fstocco-spec/esp-iot-monitor/ESP32 Gate Controller Spec v2.docx

ESP32 GATE CONTROLLER

Especificacao Tecnica de Produto

Versao 2.0

Fabio Stocco | Smatec Sistemas Embarcados

Campinas, SP | 2025

Status do Projeto | Em desenvolvimento ativo — Firmware Stages 1-6 concluidos
Hardware atual | ESP32 + 4 reles + 4 reeds + display TFT + botoes
Hardware definido (v2) | + TRIAC + ACS712 + CC1101 RF + 2 reles aux
Proxima etapa FW | Stage 7 — Reles auxiliares (trava + luz)

# 1. Visao Geral do Produto

O ESP32 Gate Controller e uma central de comando para portoes automaticos de duas folhas (pivotante, basculante ou deslizante), desenvolvida sobre plataforma ESP32 com FreeRTOS. O produto e posicionado na camada profissional-instalador: configuracao completa por display local, interface web sem dependencia de nuvem, e arquitetura de firmware modular preparada para expansao.

O diferencial central em relacao ao mercado e a combinacao de display TFT com menu completo, interface web local, e base de firmware extensivel — caracteristicas que no mercado convencional existem apenas em produtos de linha industrial ou como acessorios pagos separados.

## 1.1 Posicionamento de Mercado

Aspecto | Mercado residencial | ESP32 Gate Controller
Configuracao | LEDs piscantes + jumpers + trimpots | Display TFT com menu navegavel
Interface web | App proprietario + nuvem do fabricante | Web local, sem app, sem nuvem
Programador externo | PROG opcional R$80-120 (PPA) | Integrado — display permanente
Log de eventos | Nao disponivel | 50-100 entradas em NVS com timestamp NTP
Controle remoto | RF 433MHz OOK codigo fixo | CC1101 — OOK compativel + sensibilidade superior
Integracao smart home | App proprietario fechado | HomeKit + MQTT (roadmap)
Dependencia de fornecedor | Alta — servidor encerrado = sem app | Zero — opera standalone

## 1.2 Tipos de Portao Suportados

- Portao de duas folhas pivotante — uso principal, controle independente por folha com delay configuravel
- Portao basculante de uma folha — controle completo, reed switches de fim de curso
- Portao deslizante de uma folha — mesma logica, reed de abertura e fechamento

INFO: Para duas folhas, o controle de potencia (TRIAC) e compartilhado — ambas recebem a mesma tensao. Controle independente de velocidade por folha requer dois TRIACs (roadmap futuro).

# 2. Especificacao de Hardware

## 2.1 Bill of Materials (BOM Completo v2)

Componente | Modelo / Especificacao | Qtd | Status
MCU | ESP32-WROOM-32 DevKit 38 pinos | 1 | Atual
Display TFT | ST7735 1.8" 160x128 SPI | 1 | Atual
Modulo de reles (direcao) | 4 canais, optoacoplador, 5V, ativo HIGH | 1 | Atual
Reed switch magnetico | NO, 2 por folha (abertura + fechamento) | 4 | Atual
Botao tact | GATE, +, -, OK (4 total) | 4 | Atual
Fonte chaveada isolada | Hi-Link HLK-5M05 — 220VAC -> 5VDC | 1 | Atual
Varistor MOV | Protecao contra surto na entrada AC | 1 | Atual
Resistor pull-up | 10kOhm — GPIOs 34/35 sem pull-up interno | 2 | Atual
TRIAC | BTA24-600 — 600V 25A | 1 | HW v2
Optoacoplador gate TRIAC | MOC3021 — sem zero-crossing | 1 | HW v2
Optoacoplador zero-crossing | 4N25 + resistores divisor | 1 | HW v2
Snubber TRIAC | 100 Ohm + 10nF/400V em serie | 1 | HW v2
Sensor de corrente | ACS712-20A — efeito Hall, 100mV/A | 1 | HW v2
Modulo RF 433MHz | CC1101 com antena SMA externa | 1 | HW v2
Reles auxiliares | 5V optoacoplador — trava e luz/sinaleiro | 2 | HW v2
Fusivel AC | 2A retardado — entrada 220VAC | 1 | HW v2

## 2.2 Mapa de GPIOs

GPIO | Sinal | Direcao | Descricao | HW
25 | RELAY_L1_OPEN | OUT | Rele abertura folha 1 | Atual
26 | RELAY_L1_CLOSE | OUT | Rele fechamento folha 1 | Atual
27 | RELAY_L2_OPEN | OUT | Rele abertura folha 2 | Atual
14 | RELAY_L2_CLOSE | OUT | Rele fechamento folha 2 | Atual
13 | RELAY_AUX1 | OUT | Rele auxiliar 1 — padrao: trava | v2
12 | RELAY_AUX2 | OUT | Rele auxiliar 2 — padrao: luz/sinaleiro | v2
34 | REED_OPEN_L1 | IN | Reed abertura folha 1 — input-only, pull-up externo | Atual
35 | REED_CLOSE_L1 | IN | Reed fechamento folha 1 — input-only, pull-up externo | Atual
32 | REED_OPEN_L2 | IN | Reed abertura folha 2 — INPUT_PULLUP | Atual
33 | REED_CLOSE_L2 | IN | Reed fechamento folha 2 — INPUT_PULLUP | Atual
21 | TRIAC_GATE | OUT | PWM phase-cut via MOC3021 — LEDC timer | v2
36 | ZERO_CROSS | IN | Deteccao de zero-crossing AC — input-only | v2
39 | ACS712_OUT | ADC | Saida analoga sensor corrente — ADC1_CH3 | v2
22 | BTN_GATE | IN | Botao acionamento portao — INPUT_PULLUP | Atual
16 | BTN_MINUS | IN | Botao menu menos — INPUT_PULLUP | Atual
17 | BTN_PLUS | IN | Botao menu mais — INPUT_PULLUP | Atual
0 | BTN_OK | IN | Botao OK — INPUT_PULLUP — boot pin | Atual
5 | TFT_CS | OUT | Display chip select — SPI | Atual
2 | TFT_DC | OUT | Display data/command | Atual
4 | TFT_RST | OUT | Display reset | Atual
23 | SPI_MOSI | OUT | SPI MOSI — TFT + CC1101 compartilhado | Atual
18 | SPI_SCK | OUT | SPI SCK — TFT + CC1101 compartilhado | Atual
19 | SPI_MISO | IN | SPI MISO — CC1101 (TFT nao usa MISO) | v2
15 | CC1101_CSN | OUT | CC1101 chip select — SPI | v2
3 | CC1101_GDO0 | IN | CC1101 saida dados OOK demodulados — RX0 em producao | v2

NOTA: GPIOs 34, 35, 36, 39 sao input-only: sem pull-up interno e sem capacidade de saida. GPIO 0 e boot strapping: nivel LOW na energizacao coloca o ESP32 em modo bootloader. GPIO 12 tem strapping de tensao de flash: evitar HIGH na energizacao.

## 2.3 Arquitetura de Potencia

A alimentacao e composta por dois dominios completamente isolados:

- Dominio HV (220VAC): entrada protegida por fusivel e varistor MOV. O TRIAC BTA24 comuta a linha de fase comum dos motores. A isolacao galvanica para o dominio LV e feita pelo optoacoplador MOC3021 (gate do TRIAC) e pelo 4N25 (deteccao de zero-crossing).
- Dominio LV (5V/3.3V): Hi-Link HLK-5M05 fornece 5VDC isolado para reles e ESP32. O modulo ESP32 regula internamente para 3.3V.

Topologia do controle de potencia:

- Os reles de direcao (L1/L2 open/close) comutam apenas o caminho elétrico, nunca sob carga — o TRIAC e desligado antes de qualquer comutacao de rele, eliminando arco nos contatos.
- O TRIAC fica na linha do comum (fio compartilhado pelos dois motores). O controle de potencia e aplicado igualmente a ambas as folhas durante o movimento.
- O snubber RC (100 Ohm + 10nF) e obrigatorio em cargas indutivas para evitar disparos espurios do TRIAC por dV/dt.

NOTA: A separacao fisica (creepage distance) entre area HV e area LV no PCB deve ser no minimo 6mm conforme IPC-2221, obrigatorio para equipamentos conectados a rede de 220VAC.

# 3. Arquitetura de Firmware

## 3.1 Plataforma e Dependencias

Biblioteca | Versao | Finalidade
arduino-esp32 | >= 2.0 | Framework ESP32 Arduino
TFT_eSPI (Bodmer) | latest | Driver display ST7735
FreeRTOS | integrado | Multitarefa e sincronizacao
Preferences (ESP-IDF) | integrado | NVS — config e log nao volateis
WebServer | integrado | Servidor HTTP na porta 80
WiFi | integrado | STA mode + AP mode (portal)
time.h / NTP | integrado | Sincronizacao de hora via NTP
RC-switch | a instalar | Decodificacao protocolos 433MHz OOK
HomeSpan | a instalar | HomeKit via ESP32 (Stage 12)

## 3.2 Arquitetura FreeRTOS — Tasks

O firmware e organizado em 5 tasks independentes distribuidas nos dois cores do ESP32:

Task | Core | Prio | Stack | Funcao
taskGateController | 1 | 2 | 4KB | Maquina de estados — executa sequencias de reles, aguarda reeds, gerencia timeout
taskInputHandler | 1 | 2 | 2KB | Leitura de botoes com debounce, leitura periodica dos reed switches, envio para filas
taskDisplay | 1 | 1 | 4KB | Idle screen, menu TFT, animacoes, timeout de inatividade
taskMonitor | 0 | 1 | 2KB | Watchdog de estado, alerta de portao aberto demais, log serial periodico
taskWeb | 0 | 1 | 4KB | Loop do WebServer — atende requisicoes HTTP da interface web

INFO: O stack WiFi e LwIP TCP/IP executam nativamente no Core 0. Gate control e display estao isolados no Core 1 para que latencia de rede nao afete o timing dos reles nem a responsividade da UI.

## 3.3 Maquina de Estados do Portao

O portao opera com 6 estados bem definidos:

Estado | Descricao | Transicoes possiveis
CLOSED | Portao completamente fechado | -> OPENING (toggle)
OPENING | Sequencia de abertura em execucao | -> OPEN (reeds), -> STOPPED (toggle), -> ERROR (timeout)
OPEN | Portao completamente aberto | -> CLOSING (toggle)
CLOSING | Sequencia de fechamento em execucao | -> CLOSED (reeds), -> STOPPED (toggle), -> ERROR (timeout)
STOPPED | Movimento interrompido manualmente | -> CLOSING se ultimo movimento foi OPENING; -> OPENING se foi CLOSING
ERROR | Timeout de seguranca atingido | -> CLOSED (qualquer toggle — reset manual)

## 3.4 Sequenciamento de Folhas

Abertura (ordem normal):

- t=0: Rele L1_CLOSE OFF, dead-time 10ms, L1_OPEN ON
- t=0+: Monitor reed REED_OPEN_L1 — ao atingir LOW: L1_OPEN OFF
- t=leafDelay: Rele L2_CLOSE OFF, dead-time 10ms, L2_OPEN ON (independente do reed L1)
- t=leafDelay+: Monitor reed REED_OPEN_L2 — ao atingir LOW: L2_OPEN OFF
- t=safetyTimeout: se ainda em movimento -> relayAllOff() -> GATE_ERROR

Fechamento (ordem invertida — L2 primeiro):

- t=0: L2_OPEN OFF, dead-time 10ms, L2_CLOSE ON
- t=leafDelay: L1_OPEN OFF, dead-time 10ms, L1_CLOSE ON
- Mesma logica de reed e timeout

NOTA: O dead-time de 10ms entre desativar um rele e ativar o oposto e um interlock de hardware em software. Nunca L1_OPEN e L1_CLOSE podem estar simultaneamente ativos.

# 4. Features Implementadas (Stages 1-6)

## 4.1 Controle de Portao (Stages 1-2)

- Maquina de estados completa: CLOSED, OPENING, OPEN, CLOSING, STOPPED, ERROR
- Comando unico de toggle: abre, para, reverte e fecha com um unico acionamento
- Interlock de seguranca: reles opostos do mesmo motor nunca ativados simultaneamente
- Dead-time de 10ms entre comutacoes de rele
- Safety timeout configuravel — para forcado e vai para ERROR
- Sequencia invertida configuravel (L2 abre primeiro)
- Build timestamp exibido no boot (Serial + display)

## 4.2 Configuracao e Log (Stage 3)

Todos os parametros persistem em NVS (flash nao volatil) e sobrevivem a power cycles:

- leafDelayMs: delay entre ativacao das folhas (padrao 3000ms)
- safetyTimeoutMs: timeout maximo de movimento (padrao 20000ms)
- alertOpenMin: alerta se portao ficar aberto mais que X minutos (padrao 10min)
- sequenceInverted: inverte a ordem de abertura/fechamento das folhas
- language: idioma da UI (EN/PT) — trocavel em runtime

Log de eventos em NVS:

- FIFO de 100 entradas com timestamp yyyymmddhhmmss
- Eventos registrados: OPENED, CLOSED, STOPPED, TIMEOUT, OPEN>LIMIT, ERROR
- Timestamp populado via NTP quando online; placeholder 00000000000000 quando offline
- Chave de log formatada como e000-e099 em namespace isolado

## 4.3 WiFi e Portal de Configuracao (Stage 4)

- Modo STA: conecta a rede existente com credenciais armazenadas em NVS
- Modo AP com portal captive: ativado quando sem credenciais ou forcado pelo botao GATE no boot
- AP SSID: 'ESP32 Gate' — pagina de configuracao servida em qualquer IP
- Timeout de conexao: 10 segundos antes de cair para modo AP
- Reset de credenciais: botao OK long-press no boot OU item WiFi no menu OU botao na interface web
- NTP: pool.ntp.org, UTC-3 (Campinas), sync automatico apos conexao

## 4.4 Interface Web (Stage 4)

Servidor HTTP na porta 80, sem dependencia de nuvem ou app externo:

- Aba Status: estado atual do portao, reed switches (bolinhas LED), botao de acionamento, IP do dispositivo
- Aba Config: todos os parametros editaveis com save imediato em NVS
- Aba Log: tabela de eventos com timestamp, clear, contador de entradas
- Tema escuro, interface responsiva, funciona em qualquer browser sem instalacao
- Atualizacao de status automatica a cada 5 segundos via fetch/JSON
- Rotas: GET / (dashboard), /data (JSON status), /toggle, /config, /config-save, /log, /log-clear, /wifi-reset

## 4.5 Display TFT e Menu (Stage 6)

### Idle Screen

- Estado do portao em texto grande colorido — cor por estado: verde (aberto/abrindo), vermelho (fechado/fechando), amarelo (parado/erro)
- Animacao de setas: >>> moving right para OPENING, <<< moving left para CLOSING (5 frames, 200ms)
- Alerta 'ABERTO DEMAIS' em amarelo quando alertOpenMin e excedido
- Reed switches S1/S2: bolinhas preenchidas verde (ativo) / cinza (inativo) com labels A/F (PT) ou O/C (EN)
- Relogio HH:MM:SS canto superior direito (quando NTP sincronizado)
- IP address no rodape — atualiza somente quando muda (sem flickering)
- Borda decorativa com accent color

### Menu Navegavel

- Ativado por OK (idle) — timeout de 30s de inatividade retorna ao idle
- Navegacao: +/- para mover cursor, OK para selecionar, GATE para acao rapida
- Itens do menu raiz: Gate Control, Configuration, Event Log, WiFi, Exit
- Gate Control: toggle direto do portao pelo menu
- Configuration: 5 campos editaveis (Leaf Delay, Safety T/O, Alert Open, Sequence, Language) com edicao por +/- e save em NVS
- Event Log: scroll completo por todas as entradas + Clear Log + Back — cursor navega por tudo com +/-
- WiFi: Reset de credenciais com confirmacao e restart automatico

### Internacionalizacao

- Tabela STATE_LABELS[idioma][estado] — adicionar idioma = uma linha na tabela
- Tabela LOG_EVENT_LABELS[idioma][evento] — mesma abordagem
- Tabela WEB_STRINGS para portal web com placeholders %KEY% no HTML template
- Funcao tr(en, pt) para strings inline do display
- Sem caracteres acentuados no display — limitacao da fonte TFT_eSPI

# 5. Roadmap de Firmware — Stages 7 a 14

## Stage 7 — Reles Auxiliares

Hardware: GPIOs 12 e 13, dois reles com optoacoplador, NO/NC/COM exposto no conector.

- AUX1 — Trava eletromagnetica: sequencia configuravel de retardo antes de abrir, re-engajamento apos fechamento completo. Retardo configuravel via menu e web.
- AUX2 — Luz de garagem / sinaleiro: ativa no inicio do movimento (pre-aviso configuravel), desativa X minutos apos fechamento.
- Ambas as saidas configuráveis: tipo (trava/luz/sinaleiro/generico), modo (pulso/retencao), tempo.
- Novas entradas no menu de configuracao: Aux1 Mode, Aux1 Delay, Aux2 Mode, Aux2 Timer.
- Novos campos na interface web: secao Auxiliary Outputs na aba Config.

IMPLEMENTADO: Neste stage: so firmware, hardware ja definido e disponivel.

## Stage 8 — Modos Operacionais

- Fechamento automatico: apos X minutos com portao aberto, inicia fechamento automatico. Configuravel (0 = desabilitado). Integra com alerta existente.
- Modo pedestre: abre apenas a folha 1 (ou folha configurada) ate o reed de abertura. Folha 2 nao se move. Acionado por botao dedicado ou comando RF especifico.
- Botoeiras separadas: entradas digitais independentes para abrir (NA), fechar (NF) e toggle — alem do botao existente. Conectadas via GPIOs disponiveis.
- Memorização de percurso: no primeiro ciclo apos reset, a central aprende o tempo real de abertura e fechamento de cada folha. Usa como referencia em vez de safety timeout estatico.
- Cadeado eletronico: trava por software o acionamento RF — portao so responde ao botao fisico. Ativavel por menu, web ou horario configurado.

IMPLEMENTADO: Neste stage: so firmware, hardware atual.

## Stage 9 — RF CC1101 e Controles Remotos

- Inicializacao do CC1101 em modo OOK transparente: GDO0 configurado como saida de dados demodulados para GPIO 3.
- RC-switch library: decodificacao de protocolos 433MHz OOK — Fixed Code, Learning Code. Compatibilidade com controles PPA, Garen, RCG, AGL e equivalentes.
- Pareamento via menu: entrar em modo learn, pressionar controle, codigo gravado em NVS com ID sequencial.
- Multiplos controles: ate 32 codigos armazenados, cada um com nome configuravel e funcao (toggle / open-only / close-only / pedestre).
- Gerenciamento pelo menu: listar controles cadastrados, apagar individual ou limpar todos.
- Gerenciamento pela interface web: tabela de controles na aba Config com add/delete.
- RSSI por recepcao: rejeitar comandos com sinal abaixo de limiar configuravel (seguranca contra relay attack basico).

NOTA: Requer modulo CC1101 fisico instalado nos GPIOs definidos.

## Stage 10 — Controle de Potencia (TRIAC)

Requer hardware v2: TRIAC BTA24 + MOC3021 + 4N25 instalados.

- Deteccao de zero-crossing: ISR no GPIO 36 sincroniza o timer de phase-cut com a senóide de 60Hz.
- Phase-cut via LEDC: disparo do gate do TRIAC com delay variavel apos zero-crossing. Duty cycle 0% = corte total, 100% = conducao plena.
- Partida suave (soft-start): rampa de 0 a 100% em N ciclos configuravel. Reduz pico de corrente e impacto mecanico na partida.
- Desaceleracao nos fins de curso: ao detectar reed intermediario (ou por timeout relativo), inicia rampa descendente ate parada suave.
- Torque pulsante: bursts de potencia na partida para vencer resistencia estatica em portoes pesados.
- Freio eletronico: ao parar, corte imediato do TRIAC seguido de pulso breve do rele reverso.
- Todos os parametros (rampa, desaceleracao, torque) configuraveis por menu e web.
- Reles de direcao comutam exclusivamente com TRIAC OFF — interlock por software garantido.

NOTA: Requer hardware v2 instalado e PCB com isolacao galvanica adequada.

## Stage 11 — Sensor de Corrente e Protecoes

Requer hardware v2: ACS712-20A instalado na linha comum dos motores.

- Leitura ADC: GPIO 39 (ADC1_CH3). Vout = VCC/2 + 100mV/A. Calibracao de offset em NVS.
- Embreagem eletronica (anti-esmagamento): se corrente exceder limiar configuravel (ex: 150% da nominal), para imediatamente e reverte. Nivel configuravel por menu e web.
- Fusivel virtual: se corrente exceder limiar absoluto por mais de Xms -> GATE_ERROR. Protege motor contra travamento mecanico.
- Diagnostico de corrente: registro de corrente maxima por ciclo no log de eventos.
- Perfil de corrente normal aprendido no primeiro ciclo — desvios significativos geram alerta.
- Display: indicador de corrente atual na idle screen (opcional, configuravel).

NOTA: ADC2 do ESP32 fica desabilitado quando WiFi esta ativo. Usar exclusivamente ADC1 (GPIOs 32-39).

## Stage 12 — HomeKit

Biblioteca: HomeSpan — a mais completa para ESP32, suporte nativo a FreeRTOS.

- Dispositivo HomeKit: GarageDoorOpener com estados open/closed/opening/closing/stopped.
- Duas folhas: um unico acessorio representando o portao completo (nao dois separados).
- Widget CarPlay: visualizacao e acionamento direto no CarPlay e Siri ('Fechar portao').
- Notificacoes: configuravel para notificar abertura, fechamento, alerta de aberto demais.
- Emparelhamento local via QR code — sem conta Apple necessaria alem do iCloud do usuario.
- homeSpan.poll() executado em task dedicada no Core 0 para nao interferir com taskWeb.

## Stage 13 — MQTT e Acesso Remoto

- Broker configuravel: host, porta, usuario, senha — armazenados em NVS.
- Publish: esp32gate/state, esp32gate/reeds, esp32gate/alert, esp32gate/log/last.
- Subscribe: esp32gate/cmd/toggle, esp32gate/cmd/open, esp32gate/cmd/close, esp32gate/config/set.
- Payload JSON em todos os topicos.
- Reconexao automatica com backoff exponencial.
- Integracao direta com Home Assistant via MQTT Discovery (auto-configuracao).
- Integracao com Node-RED para automacoes customizadas e notificacoes push.

## Stage 14 — OTA Firmware Update

- OTA via interface web: upload de .bin diretamente pela aba Admin do dashboard.
- OTA via MQTT: publicar URL de novo firmware em topico dedicado dispara download e atualizacao.
- Verificacao de integridade: MD5 do firmware antes de aplicar.
- Rollback automatico: se novo firmware nao confirmar boot em 60s, restaura versao anterior.
- Display: barra de progresso durante OTA, tela de restart.

# 6. Status Geral das Features

Feature | Descricao resumida | Stage | Status
Maquina de estados | 6 estados, toggle, stop, reverse | 1-2 | Implementado
Sequenciamento de folhas | Delay configuravel, interlock, timeout | 2 | Implementado
Reed switches | 4 sensores fim de curso com pull-up | 2 | Implementado
NVS config | 5 parametros persistentes | 3 | Implementado
Log de eventos | 100 entradas FIFO com timestamp NTP | 3 | Implementado
WiFi STA + portal AP | Conexao, fallback, captive portal | 4 | Implementado
Interface web | Dashboard 3 abas sem app nem nuvem | 4 | Implementado
NTP | Sincronizacao UTC-3, fallback offline | 4 | Implementado
Display TFT idle | Estado, reeds, animacao, IP, relogio | 6 | Implementado
Menu display | Config, log, gate ctrl, WiFi, exit | 6 | Implementado
Internacionalizacao | EN/PT por tabelas — extensivel | 6 | Implementado
Reles auxiliares (trava/luz) | GPIO 12/13, configuravel | 7 | Em desenvolvimento
Fechamento automatico | Timer configuravel pos-abertura | 8 | Em desenvolvimento
Modo pedestre | Abre so folha 1 | 8 | Em desenvolvimento
Botoeiras separadas | Open/Close/Toggle independentes | 8 | Em desenvolvimento
Memorizacao de percurso | Aprende tempo real de movimento | 8 | Em desenvolvimento
Cadeado eletronico | Bloqueio por software do RF | 8 | Em desenvolvimento
RF CC1101 + RC-switch | Controles 433MHz OOK existentes | 9 | Em desenvolvimento
Pareamento de controles | Menu + web, ate 32 controles | 9 | Em desenvolvimento
TRIAC phase-cut | Partida suave, desaceleracao, freio | 10 | Pendente HW
Sensor de corrente ACS712 | Anti-esmagamento, fusivel virtual | 11 | Pendente HW
HomeKit (HomeSpan) | GarageDoor, Siri, CarPlay widget | 12 | Planejado
MQTT + Home Assistant | Acesso remoto, automacoes | 13 | Planejado
OTA firmware update | Via web ou MQTT | 14 | Planejado

# 7. Notas de Producao e Seguranca

NOTA: Este controlador comuta circuitos de motor em 220VAC. Os itens abaixo sao obrigatorios em qualquer instalacao.

## 7.1 Requisitos de Hardware Obrigatorios

- Isolacao galvanica entre ESP32 (3.3V logica) e contatos dos reles (220VAC)
- Modulo de reles com optoacopladores integrados (ex: EL817) — nunca reles diretos
- Fonte chaveada isolada (Hi-Link HLK-5M05 ou equivalente) — nunca fonte nao-isolada
- Varistor MOV na entrada 220VAC para protecao contra surtos
- Fusivel 2A retardado na entrada 220VAC
- Barreira fisica entre secao HV e LV dentro do gabinete
- Creepage distance minima de 6mm entre trilhas HV e LV no PCB (IPC-2221)
- Snubber RC obrigatorio no TRIAC (carga indutiva — motor AC)

## 7.2 Requisitos de Instalacao

- Fotocélula ou borda de seguranca obrigatorias em instalacoes com transito de pessoas
- Luz de aviso (sinaleiro) recomendada — Stage 7 implementa a saida AUX2
- Aterramento do gabinete metalico
- Protecao contra intemperies — gabinete IP54 minimo para uso externo

## 7.3 Observacoes de Firmware

- GPIO 0 e boot strapping — botao OK nao deve estar pressionado durante energizacao
- ADC2 fica desabilitado quando WiFi esta ativo — usar apenas ADC1 (GPIOs 32-39) para ACS712
- GPIOs 34, 35, 36, 39 sao input-only — sem capacidade de saida, sem pull-up interno
- GPIO 3 (RX0) e usado para CC1101_GDO0 — Serial.println desabilitado em producao neste pino
- GPIO 12 tem strapping de tensao de flash — evitar nivel HIGH durante energizacao

## 7.4 Configuracoes Padrao de Fabrica

Parametro | Padrao | Minimo | Maximo
Leaf Delay (ms) | 3000 | 0 | 30000
Safety Timeout (ms) | 20000 | 1000 | 60000
Alert Open (min) | 10 | 1 | 120
Sequence Inverted | false | — | —
Language | EN | — | —
Auto-close Timer (min) | 0 (desabilitado) | 0 | 60
Embreagem (nivel) | 5 de 10 | 1 | 10
Rampa partida (ciclos) | 10 | 0 | 30
Rampa parada (ciclos) | 8 | 0 | 20

# 8. Comparativo com o Mercado (Produto Final)

Quando o roadmap estiver completo (Stage 14), o ESP32 Gate Controller tera o seguinte perfil em relacao ao mercado:

Feature | Basico (PPA AC-4) | Premium (PPA Facility Top) | ESP32 Gate Controller
Configuracao | LEDs + jumpers | PROG externo pago | Display integrado + web
Interface web | Nao | Wi-Fi Connect (pago) | Nativa, local, sem nuvem
Log de eventos | Nao | Nao | 100 entradas NTP
HomeKit / Siri | Nao | Nao | Sim (Stage 12)
MQTT / HA | Nao | Nao | Sim (Stage 13)
OTA | Nao | Nao | Sim (Stage 14)
Anti-esmagamento | Embreagem analogica | Embreagem eletronica | ACS712 digital (Stage 11)
Partida suave | Nao | Sim | Sim — TRIAC (Stage 10)
RF compativel | 433 OOK | 433 OOK + rolling code | CC1101 OOK (Stage 9)
Trava eletromagnetica | Modulo opcional | Modulo opcional | Integrado (Stage 7)
Auto-close | Sim | Sim | Sim (Stage 8)
Modo pedestre | Alguns modelos | Sim | Sim (Stage 8)
Preco estimado BOM | R$ 80-150 | R$ 200-350 | < R$ 150
Dependencia de nuvem | Alta | Media | Zero

INFO: O custo de BOM do ESP32 Gate Controller e estimado de forma conservadora e pode variar conforme fornecedor e escala de producao.

Fabio Stocco | Smatec Sistemas Embarcados | Campinas, SP

Fabio Stocco / Smatec

ESP32 Gate Controller Especificacao de Produto v2.0
