fstocco-spec/esp-iot-monitor/ESP32 Gate Manual Usuario v1.docx

ESP32 GATE CONTROLLER

Manual do Usuario

Central de Comando para Portao Automatico

Versao 1.0 | Smatec Sistemas Embarcados

# 1. Introducao

O ESP32 Gate Controller e uma central de comando para portoes automaticos desenvolvida sobre plataforma ESP32 com sistema operacional em tempo real (FreeRTOS). O produto oferece controle completo de portoes de duas folhas (pivotante), uma folha (basculante ou deslizante) com configuracao local por display TFT, interface web local sem dependencia de nuvem ou aplicativo externo, e um conjunto completo de funcoes de seguranca e automacao.

## 1.1 Caracteristicas Principais

- Controle de portao de uma ou duas folhas com sequenciamento configuravel
- Display TFT 160x128 com menu completo de configuracao
- Interface web acessivel por qualquer browser na rede local
- Configuracao completa por display ou web — sem jumpers ou trimpots
- Log de eventos com timestamp (sincronizado por NTP)
- Dois reles auxiliares configuráveis: trava eletromagnetica, luz, sirene
- Sistema de alarmes: arrombamento, portao aberto demais, falha de motor
- UI bilíngue: Portugues e Ingles
- Sem dependencia de nuvem, aplicativo ou servidor externo

## 1.2 Tipos de Portao Suportados

Tipo | Descricao | Folhas
Pivotante duas folhas | Controle independente de cada folha com delay configuravel | 2
Basculante | Uma folha, controle completo com sensores de fim de curso | 1
Deslizante | Uma folha, logica identica ao basculante | 1

# 2. Instalacao de Hardware

ATENCAO: Este equipamento opera com 220VAC. A instalacao deve ser realizada por profissional habilitado. Leia todas as instrucoes antes de iniciar.

## 2.1 Esquema de Ligacao

### Motores

Cada motor possui 3 fios: Comum, Horario (CC) e Anti-Horario (CCW). O fio Comum de ambos os motores passa pelo TRIAC da central antes de chegar a rede AC. Os reles selecionam a direcao de cada motor.

Terminal | Ligacao
REDE AC | Fase e Neutro da rede 220VAC
COM M1 | Fio Comum do motor 1 (passa pelo TRIAC interno)
CC M1 | Fio Horario do motor 1
CCW M1 | Fio Anti-Horario do motor 1
COM M2 | Fio Comum do motor 2
CC M2 | Fio Horario do motor 2
CCW M2 | Fio Anti-Horario do motor 2

### Sensores de Fim de Curso (FC)

Cada folha possui dois sensores magneticos: FC Abertura e FC Fechamento. O sensor deve estar normalmente aberto (NA) e fechar quando o ima estiver presente.

Terminal | Sensor
FC1-ABR | Fim de curso abertura — Folha 1
FC1-FCH | Fim de curso fechamento — Folha 1
FC2-ABR | Fim de curso abertura — Folha 2
FC2-FCH | Fim de curso fechamento — Folha 2
GND | Terra dos sensores

ATENCAO: Os terminais FC1-ABR e FC1-FCH (GPIOs 34/35) requerem resistor pull-up externo de 10kOhm para 3.3V. Os terminais FC2-ABR e FC2-FCH (GPIOs 32/33) tambem usam pull-up externo para consistencia. Nao conecte sem os resistores.

DICA: POSICIONAMENTO DO SENSOR FC.F (fechamento): Para maxima efetividade do alarme de arrombamento, instale o sensor de fechamento diretamente na folha do portao — nao no braco do motor. Desta forma, qualquer abertura minima da folha (mesmo fracao de centimetro) ja desativa o sensor e dispara o alarme imediatamente. Se instalado no braco do motor, o portao pode ser aberto alguns centimetros antes do sensor detectar o movimento.

### Botoeira

Terminal | Funcao
BOT | Botoeira de acionamento (toggle) — contato NA
GND | Terra da botoeira

### Reles Auxiliares

Terminal | Funcao Padrao | Configuravel
AUX1-NO | Trava eletromagnetica — normalmente aberto | Sim
AUX1-NC | Trava eletromagnetica — normalmente fechado | Sim
AUX1-COM | Comum AUX1 | —
AUX2-NO | Luz de garagem / Sinaleiro — normalmente aberto | Sim
AUX2-NC | Luz de garagem / Sinaleiro — normalmente fechado | Sim
AUX2-COM | Comum AUX2 | —

# 3. Primeiro Uso

## 3.1 Ligando pela Primeira Vez

Ao ligar a central pela primeira vez, o display exibe a versao do firmware e entra na tela principal (idle screen). Como nao ha credenciais WiFi armazenadas, a central entra automaticamente em modo Access Point.

## 3.2 Configuracao WiFi Inicial

- No celular ou computador, procure a rede WiFi chamada ESP32 Gate
- Conecte-se a esta rede (sem senha)
- Abra o browser e acesse qualquer URL — sera redirecionado para o portal de configuracao
- Insira o nome (SSID) e a senha da sua rede WiFi
- Clique em Salvar — a central reinicia e conecta automaticamente
- O IP da central aparece no rodape do display apos a conexao

NOTA: Se a central nao conseguir conectar a rede configurada em 10 segundos, ela volta ao modo AP automaticamente.

## 3.3 Acessando a Interface Web

Com a central conectada a sua rede WiFi, acesse o IP exibido no display em qualquer browser. Exemplo: http://192.168.1.100

A interface web possui tres abas:

- Estado — situacao atual do portao, sensores e botao de acionamento
- Config — todos os parametros de configuracao
- Log — historico de eventos

# 4. Display e Navegacao

## 4.1 Tela Principal (Idle Screen)

A tela principal exibe as informacoes de operacao em tempo real:

Regiao | Conteudo
Header (topo) | Nome do dispositivo e relogio em tempo real (quando NTP sincronizado)
Centro grande | Estado atual do portao em texto grande e colorido
Sublinhado colorido | Linha na cor do estado abaixo do label
Area de setas | Animacao de setas >>> (abrindo) ou <<< (fechando) durante o movimento
Area de alarme | Mensagem de alarme quando ativo (sobrepoe as setas)
Sensores FC | FC1 e FC2 com indicadores: A (abertura) e F (fechamento) — bolinha verde = ativo
Rodape | Endereco IP da central na rede

### Cores dos Estados

Estado | Cor | Significado
ABERTO | Verde | Portao completamente aberto
ABRINDO | Verde | Sequencia de abertura em execucao
FECHADO | Vermelho | Portao completamente fechado
FECHANDO | Vermelho | Sequencia de fechamento em execucao
PARADO | Amarelo | Movimento interrompido manualmente
ERRO | Amarelo | Timeout de seguranca atingido

## 4.2 Botoes de Navegacao

Botao | Na tela principal | No menu
GATE | Aciona o portao (toggle) | Acao rapida / alternativa
OK | Entra no menu | Seleciona o item atual / salva edicao
[+] | — | Move cursor para baixo / incrementa valor
[-] | — | Move cursor para cima / decrementa valor
OK longo (3s no boot) | Reset WiFi | —

## 4.3 Estrutura do Menu

Pressione OK na tela principal para entrar no menu. O menu retorna automaticamente a tela principal apos 30 segundos sem interacao.

Item | Sub-itens | Funcao
Controle | Acionar | Aciona o portao diretamente pelo menu
Configuracao | 9 parametros | Edita todos os parametros (ver secao 5)
Registro | Entradas + Limpar + Voltar | Visualiza o log de eventos
WiFi | Resetar / Voltar | Apaga credenciais e reinicia em modo AP
Sair | — | Retorna a tela principal

NOTA: No menu de Registro, +/- navega por todas as entradas E pelos botoes Limpar/Voltar. Nao e necessario pressionar GATE para chegar nas acoes.

# 5. Configuracoes

Todos os parametros podem ser alterados pelo menu do display ou pela aba Config da interface web. As configuracoes sao salvas permanentemente na memoria nao-volatil (NVS) e sobrevivem a quedas de energia.

## 5.1 Parametros de Movimento

Parametro | Padrao | Faixa | Descricao
Delay Folha (ms) | 3000 | 0 — 30000 | Tempo em milissegundos entre o acionamento da folha 1 e da folha 2. Para portao de uma folha, ignorado.
Timeout Seguranca (ms) | 20000 | 1000 — 60000 | Tempo maximo de movimento. Se o portao nao atingir o fim de curso neste tempo, para forcado e entra em estado ERRO.
Sequencia Invertida | Normal | Normal / Invertida | Normal: Folha 1 abre primeiro. Invertida: Folha 2 abre primeiro. Para portao de uma folha, sem efeito.

## 5.2 Parametros de Alerta

Parametro | Padrao | Faixa | Descricao
Aberto Demais (min) | 10 | 0 — 120 | Tempo em minutos que o portao pode ficar aberto antes de gerar alerta. Valor 0 desabilita completamente o alarme de aberto demais — nenhum log, nenhum alerta, nenhuma sirene.

## 5.3 Reles Auxiliares

Cada rele auxiliar (AUX1 e AUX2) e configurado independentemente com um modo de operacao e um parametro de tempo. O parametro de tempo muda de significado conforme o modo escolhido.

Modo | Parametro de Tempo | Comportamento
Desabilitado | — (oculto) | Rele nunca aciona. Botao de teste nao aparece.
Trava | Delay Liberacao (s) 0 — 30 segundos | Libera a trava antes de iniciar a abertura, aguarda o tempo configurado e entao inicia o movimento. Engaja (trava) apos o fechamento completo.
Luz | Timer Luz (min) 0 — 30 minutos | Liga durante qualquer movimento (abrindo ou fechando). Apos o fechamento completo, permanece ligada pelo tempo configurado e entao desliga. Timer 0 = desliga imediatamente ao fechar.
Sirene | — (sem parametro) | Liga quando um alarme e disparado (arrombamento ou portao aberto demais, conforme configuracao de alarmes). Desliga quando o portao fecha ou o alarme e desativado.

NOTA: AUX1 e AUX2 podem ter funcoes diferentes ou iguais. E possivel ter dois modos iguais em canais diferentes — por exemplo, duas travas em portas diferentes.

### Teste dos Reles Auxiliares

Na aba Config da interface web, a secao Teste Aux exibe um botao para cada canal configurado (nao aparece se o canal estiver desabilitado). O comportamento do teste:

- Trava: libera por N segundos (conforme o delay configurado) e engaja novamente
- Luz: liga pelo tempo configurado (minimo 5 segundos se timer for 0)
- Sirene: toggle — liga se estiver desligada, desliga se estiver ligada

## 5.4 Alarmes

O sistema possui tres alarmes independentes. Cada um pode ser habilitado ou desabilitado individualmente. O disparo de alarme sempre grava no log e exibe mensagem no display. A sirene so e acionada se houver um canal AUX configurado como Sirene E o respectivo alarme estiver habilitado para sirene.

### Alarme de Arrombamento

Campo | Descricao
Sirene Arrombamento | Habilita ou desabilita o acionamento da sirene ao detectar abertura forcada. O alerta no display e o registro no log sempre ocorrem independentemente desta configuracao.

Trigger: o sensor de fim de curso de abertura (FC-ABR) de qualquer folha ativa enquanto o portao esta no estado FECHADO e sem comando de motor ativo. Isso indica que o portao foi aberto fisicamente sem acionamento pelo sistema.

Mensagem no display: !! ARROMBA FC1 !! ou !! ARROMBA FC2 !! em vermelho.

Condicao de reset: o portao fechar completamente.

### Alarme de Aberto Demais

Campo | Descricao
Aberto Demais (min) | Tempo em minutos. Valor 0 desabilita o alarme inteiramente.
Sirene Aberto Demais | Habilita ou desabilita a sirene quando o portao fica aberto demais. O alerta no display e o log sempre ocorrem quando o timer > 0.

Trigger: portao permanece no estado ABERTO por mais tempo que o configurado.

Mensagem no display: ABERTO DEMAIS em amarelo.

Condicao de reset: o portao fechar completamente.

DICA: Para locais com grande fluxo de veiculos onde o portao precisa ficar aberto por longos periodos, configure Aberto Demais (min) = 0 para desabilitar completamente este alarme.

### Deteccao de Falha de Motor

Campo | Descricao
Detectar Falha Motor | Habilita ou desabilita a deteccao de falha de motor. Quando habilitado, o rele do motor e acionado mas o sensor de fim de curso correspondente nao responde em 5 segundos — o movimento e interrompido e o erro e registrado.

Trigger: rele de motor acionado por mais de 5 segundos sem resposta do reed switch correspondente.

Mensagem no display: ERRO MOTOR FC1 ou ERRO MOTOR FC2 em amarelo.

Acao: para o motor imediatamente e vai para estado ERRO.

NOTA: A sirene nao e acionada em falha de motor — e uma falha tecnica, nao um evento de seguranca.

## 5.5 Idioma

Opcao | Descricao
EN (Ingles) | Interface do display e web em ingles
PT (Portugues) | Interface do display e web em portugues. Nota: o display nao suporta caracteres acentuados — palavras com acento sao exibidas sem acentuacao.

NOTA: Ao salvar a configuracao de idioma, a interface web recarrega automaticamente no novo idioma.

# 6. Operacao

## 6.1 Maquina de Estados

O portao opera com 6 estados bem definidos. O diagrama abaixo mostra as transicoes possiveis:

Estado | Proximo Estado | Condicao
FECHADO | ABRINDO | Comando toggle
ABRINDO | ABERTO | Ambos os sensores de abertura ativos
ABRINDO | PARADO | Comando toggle durante o movimento
ABRINDO | ERRO | Timeout de seguranca atingido
ABERTO | FECHANDO | Comando toggle
FECHANDO | FECHADO | Ambos os sensores de fechamento ativos
FECHANDO | PARADO | Comando toggle durante o movimento
FECHANDO | ERRO | Timeout de seguranca atingido
PARADO | FECHANDO | Comando toggle (se ultimo movimento foi ABRINDO)
PARADO | ABRINDO | Comando toggle (se ultimo movimento foi FECHANDO)
ERRO | FECHADO | Qualquer comando toggle — reset manual

## 6.2 Sequenciamento de Duas Folhas

Para portao de duas folhas, o movimento segue esta sequencia:

### Abertura (ordem normal)

- t=0: Rele da folha 1 acionado em modo Abertura
- t=0+: Monitor do sensor FC1-ABR. Ao atingir fim de curso: motor 1 desligado
- t=Delay Folha: Rele da folha 2 acionado em modo Abertura (independente do sensor da folha 1)
- t=Delay Folha+: Monitor do sensor FC2-ABR. Ao atingir fim de curso: motor 2 desligado
- t=Timeout Seguranca: se ainda em movimento — para forcado e vai para ERRO

### Fechamento (ordem invertida — folha 2 primeiro)

- t=0: Rele da folha 2 acionado em modo Fechamento
- t=Delay Folha: Rele da folha 1 acionado em modo Fechamento
- Mesma logica de sensores e timeout

NOTA: Com Sequencia Invertida habilitada, a folha 2 abre primeiro e a folha 1 fecha primeiro.

## 6.3 Seguranca dos Reles

O sistema garante que os reles de direcao opostos do mesmo motor (ex: Horario e Anti-Horario da folha 1) nunca sejam ativados simultaneamente. Um intervalo minimo de 10ms e mantido entre a desativacao de um rele e a ativacao do oposto.

Quando o TRIAC estiver instalado, os reles de direcao sao comutados exclusivamente com o TRIAC desligado, eliminando arco eletrico nos contatos e aumentando a vida util dos reles.

# 7. Interface Web

A interface web e servida diretamente pela central na porta 80. Nao requer app, nuvem ou cadastro. Funciona em qualquer browser — celular, tablet ou computador.

## 7.1 Aba Estado

Elemento | Descricao
Estado do Portao | Exibe o estado atual em texto grande (FECHADO, ABERTO, etc.)
FC1/FC2 Indicadores | Quatro bolinhas — verde = sensor ativo, cinza = inativo. Abertura e fechamento de cada folha.
Acionar Portao | Botao de toggle — mesma funcao do botao GATE fisico
Resetar WiFi | Apaga credenciais WiFi e reinicia em modo Access Point

## 7.2 Aba Config

Todos os parametros descritos na secao 5 estao disponiveis aqui. A pagina e recarregada automaticamente apos salvar para refletir o idioma selecionado.

Organizacao da aba:

- Secao principal: Delay Folha, Timeout Seguranca, Sequencia, Idioma
- Aux Outputs: configuracao de AUX1 e AUX2 com campo de tempo dinamico
- Teste Aux: botoes de teste para canais habilitados
- Alarmes: tempo de alerta de aberto, toggles de sirene para cada tipo de alarme
- Resetar WiFi: botao para apagar credenciais

## 7.3 Aba Log

Elemento | Descricao
Contador | Numero de registros armazenados (maximo 100)
Tabela de eventos | Lista dos eventos em ordem cronologica inversa (mais recente primeiro)
Timestamp | Data e hora no formato DD/MM HH:MM (requer NTP sincronizado)
Limpar Log | Apaga todos os registros apos confirmacao

### Tipos de Eventos Registrados

Evento | Descricao
ABERTO | Portao atingiu estado completamente aberto
FECHADO | Portao atingiu estado completamente fechado
PARADO | Movimento interrompido por comando
TIMEOUT | Timeout de seguranca atingido — portao parado por seguranca
ABERTO>LIM | Portao permaneceu aberto alem do tempo configurado
ERRO | Erro generico de operacao
ARROMBA-FC1 | Abertura forcada detectada no sensor FC1
ARROMBA-FC2 | Abertura forcada detectada no sensor FC2
MOTOR-FC1 | Falha de motor: FC1 nao respondeu em 5 segundos
MOTOR-FC2 | Falha de motor: FC2 nao respondeu em 5 segundos

# 8. Log de Eventos pelo Display

O log pode ser visualizado e gerenciado diretamente pelo menu do display sem necessidade de acesso web.

- No menu principal, selecione Registro
- Use +/- para navegar pelas entradas — o cursor percorre todas as entradas e tambem os botoes Limpar Log e Voltar
- Cada entrada exibe o tipo de evento a esquerda e a data/hora (DD/MM HH:MM) a direita
- Entradas sem timestamp NTP exibem apenas o evento
- Para limpar: navegue ate Limpar Log e pressione OK — o log e apagado imediatamente
- Para sair: navegue ate Voltar e pressione OK, ou aguarde 30 segundos

# 9. WiFi e Conectividade

## 9.1 Modos de Operacao WiFi

Modo | Quando ativo | Como acessar
STA (cliente) | Credenciais configuradas e rede disponivel | Pelo IP exibido no display
AP (ponto de acesso) | Sem credenciais ou falha de conexao | Conectar na rede ESP32 Gate e acessar qualquer URL

## 9.2 Reset de WiFi

Ha tres formas de resetar as credenciais WiFi:

- Display: Menu > WiFi > Resetar WiFi
- Interface web: Aba Config > Resetar WiFi Credentials
- Boot: segure o botao OK ao ligar — aguarde 3 segundos

NOTA: Apos o reset, a central reinicia automaticamente em modo AP. Configure as novas credenciais pelo portal.

## 9.3 NTP — Sincronizacao de Horario

A central sincroniza o relogio automaticamente com o servidor pool.ntp.org apos conectar ao WiFi. O fuso horario e UTC-3 (Brasil — Campinas/SP).

Quando o NTP nao esta sincronizado, os registros do log recebem o timestamp 00000000000000 e o relogio nao e exibido no display.

# 10. Solucao de Problemas

Sintoma | Causa Provavel | Solucao
Portao nao abre/fecha | Rele ou ligacao do motor | Verificar ligacao dos reles e do motor. Checar estado no display.
Estado ERRO no display | Timeout de seguranca atingido | Verificar sensores de fim de curso. Aumentar Timeout Seguranca se necessario.
ERRO MOTOR FCx no display | Sensor nao responde em 5s | Verificar posicionamento do ima e do sensor. Verificar ligacao do sensor.
Sirene ativa sem razao aparente | Reed de abertura disparando | Verificar imã do sensor de abertura. Verificar se portao esta completamente fechado.
Display sem relogio | NTP nao sincronizado | Verificar conexao WiFi. IP deve aparecer no rodape do display.
Interface web nao abre | IP incorreto ou WiFi desconectado | Verificar IP no rodape do display. Verificar conexao WiFi.
Portao abre folha 2 antes da 1 | Sequencia Invertida ativa | Menu ou web: Sequencia > Normal.
Folha 1 para, folha 2 nao inicia | Delay Folha muito alto | Reduzir Delay Folha. O delay e contado a partir do inicio, nao do fim de curso.
Log enchendo rapido | Alarme de aberto demais muito baixo | Aumentar o tempo ou desabilitar (valor 0).
Reset indesejado ao pressionar OK | GPIO 0 = boot pin | Nao segurar OK durante energizacao da central.

# 11. Especificacoes Tecnicas

Parametro | Valor
Alimentacao | 220VAC 50/60Hz
Consumo em standby | < 2W (fonte HLK-5M05)
Tensao logica | 3.3VDC (ESP32)
Reles de motor | 4x — 250VAC 15A
Reles auxiliares | 2x — 250VAC 15A
Sensores de fim de curso | 4x reed switch magnetico NA
Display | TFT ST7735 1.8" 160x128 pixels
WiFi | 802.11 b/g/n 2.4GHz
Log de eventos | 100 entradas em NVS
Temperatura de operacao | 0 a 60 graus C
Grau de protecao | IP20 (uso em ambiente fechado)

## 11.1 Parametros de Configuracao — Referencia Rapida

Parametro | Padrao | Faixa | Unidade
Delay Folha | 3000 | 0 — 30000 | ms
Timeout Seguranca | 20000 | 1000 — 60000 | ms
Alerta Aberto | 10 | 0 — 120 | minutos (0=desabilitado)
Sequencia | Normal | Normal / Invertida | —
Idioma | EN | EN / PT | —
AUX Modo | Trava/Luz | Desabilitado/Trava/Luz/Sirene | —
AUX Delay Trava | 2 | 0 — 30 | segundos
AUX Timer Luz | 2 | 0 — 30 | minutos
Sirene Arrombamento | ON | ON / OFF | —
Sirene Aberto Demais | ON | ON / OFF | —
Detectar Falha Motor | ON | ON / OFF | —

Smatec Sistemas Embarcados | Campinas, SP | www.smatec.com.br

Smatec Sistemas Embarcados

ESP32 Gate Controller Manual do Usuario
