fstocco-spec/esp-iot-monitor/esp32gate schematic.pdf

## ESP32 GATE CONTROLLER — HARDWARE REFERENCE

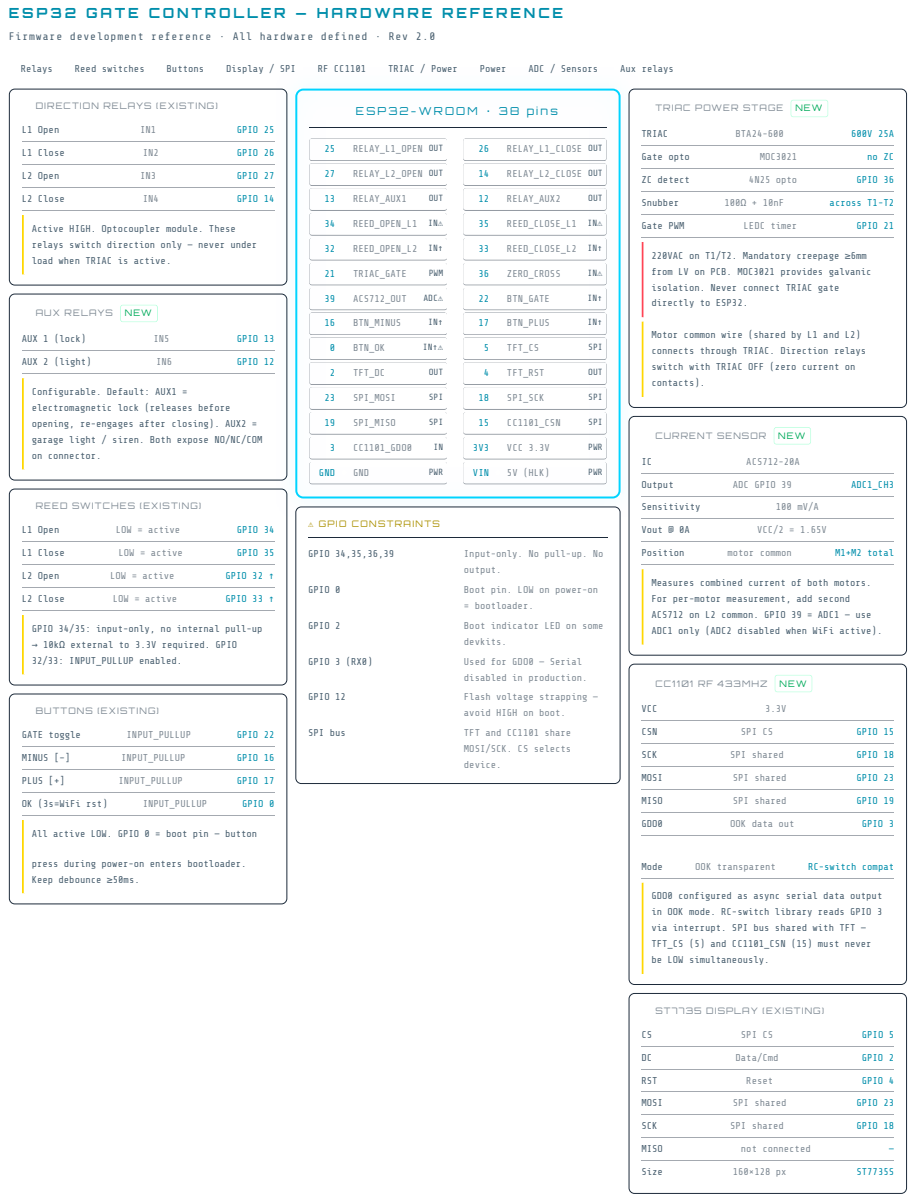
[picture p1: page 1]
Relays; Reed switches; Buttons; Display / SPI; TRIAC / Power; Power; ADC / Sensors; Aux relays; L1 Open; GPIO 25; L1 Close; GPIO 26; L2 Open; GPIO 27; L2 Close; GPIO 14; AUX 1 (lock); GPIO 13; AUX 2 (light); GPIO 12; LOW = active; GPIO 34; GPIO 35; GPIO 32 ↑; GPIO 33 ↑; BUTTONS (EXISTING); GATE toggle; INPUT_PULLUP; GPIO 22; MINUS [–]; GPIO 16; PLUS [+]; GPIO 17; OK (3s=WiFi rst); GPIO 0; ESP32-WROOM · 38 pins; ⚠ GPIO CONSTRAINTS; GPIO 34,35,36,39; Input-only. No pull-up. No; output.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

Firmware development reference · All hardware defined · Rev 2.0

DIRECTION RELAYS (EXISTING)

TRIAC POWER STAGE NEW

Active HIGH. Optocoupler module. These
relays switch direction only — never under
load when TRIAC is active.

220VAC on T1/T2. Mandatory creepage ≥6mm
from LV on PCB. MOC3021 provides galvanic
isolation. Never connect TRIAC gate
directly to ESP32.

AUX RELAYS NEW

Motor common wire (shared by L1 and L2)
connects through TRIAC. Direction relays
switch with TRIAC OFF (zero current on
contacts).

Configurable. Default: AUX1 =
electromagnetic lock (releases before
opening, re-engages after closing). AUX2 =
garage light / siren. Both expose NO/NC/COM
on connector.

CURRENT SENSOR NEW

REED SWITCHES (EXISTING)

Measures combined current of both motors.
For per-motor measurement, add second
ACS712 on L2 common. GPIO 39 = ADC1 — use
ADC1 only (ADC2 disabled when WiFi active).

GPIO 34/35: input-only, no internal pull-up
→ 10kΩ external to 3.3V required. GPIO
32/33: INPUT_PULLUP enabled.

disabled in production.

avoid HIGH on boot.

MOSI/SCK. CS selects
device.

All active LOW. GPIO 0 = boot pin — button

press during power-on enters bootloader.
Keep debounce ≥50ms.

GDO0 configured as async serial data output
in OOK mode. RC-switch library reads GPIO 3
via interrupt. SPI bus shared with TFT —
TFT_CS (5) and CC1101_CSN (15) must never
be LOW simultaneously.

POWER ARCHITECTURE

AC input | 220VAC (BR)
Surge protection | MOV varistor
AC fuse | 2A slow-blow
PSU | HLK-5M05 → 5VDC
3.3V reg | AMS1117 (on ESP32 module)
Relay coils | 5VDC
TRIAC supply | directly from 220VAC
Isolation | MOC3021 + 4N25

FIRMWARE FEATURES — STATUS

State machine | ✓ done
Reed / sequence | ✓ done
WiFi + Web UI | ✓ done
NVS config + log | ✓ done
TFT display menu | ✓ done
Aux relays (lock/light) | ⟳ next
RF CC1101 / RC-switch | ⟳ next
Auto-close / pedestrian | ⟳ next
TRIAC phase-cut | ○ hw pending
ACS712 current sense | ○ hw pending
HomeKit (HomeSpan) | ○ later
MQTT | ○ later

SUGGESTED FW SEQUENCE

Stage 7 | Aux relays + lock logic
Stage 8 | Auto-close + pedestrian mode
Stage 9 | RF CC1101 + RC-switch + pairing
Stage 10 | TRIAC phase-cut + soft-start
Stage 11 | ACS712 + anti-crush + fusível virtual
Stage 12 | HomeKit (HomeSpan)
Stage 13 | MQTT + remote access
Stage 14 | OTA firmware update

Stages 10–11 require new hardware. Stages 7–9 run on current hardware.
